anas-ambri/contactless-life-monitoring/host/README.md

#Installation
Need to install libusb and pyusb
libusb doesn't work on mac osx

#Board USB info
Vendor Id = 0x1FC9
Product Id = 0x0081

#Access denied (insufficient permissions)

http://ubuntuforums.org/showthread.php?t=1342955&s=b87c6f5342350bd3af2c09dd516f7416&p=8432338#post8432338
