anas-ambri/contactless-life-monitoring/Algo/figs/dat_diff1.png

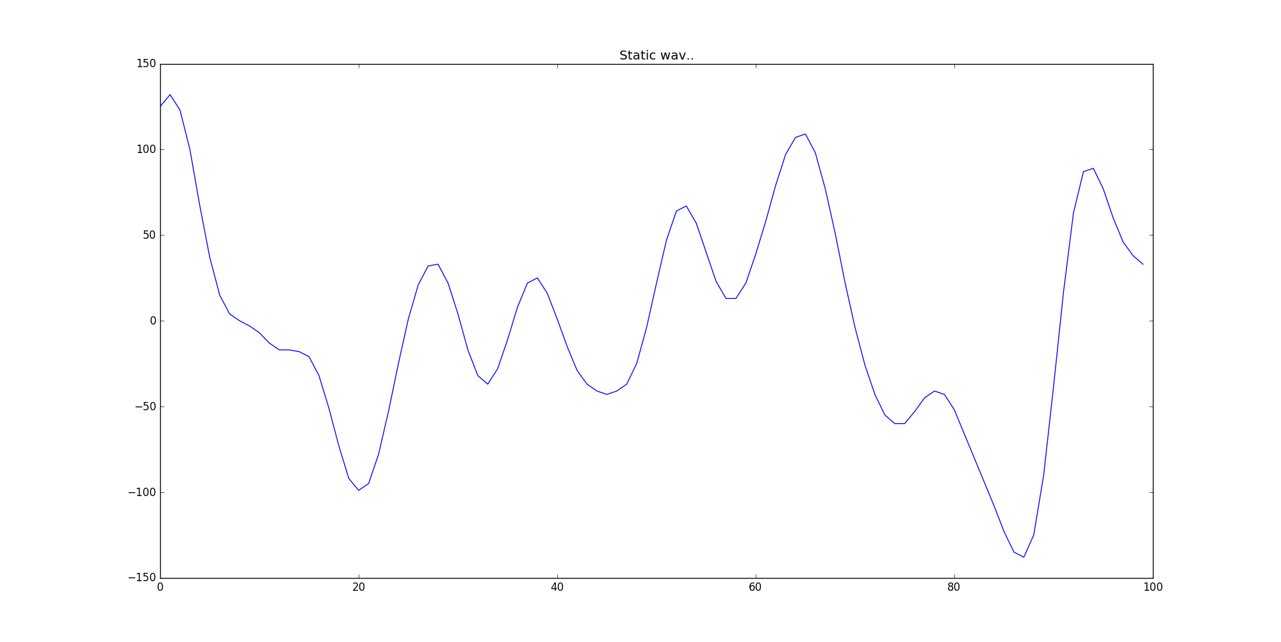
Algo/figs/dat_diff1.png
