anas-ambri/contactless-life-monitoring/antenna/Antenna_housing.stl

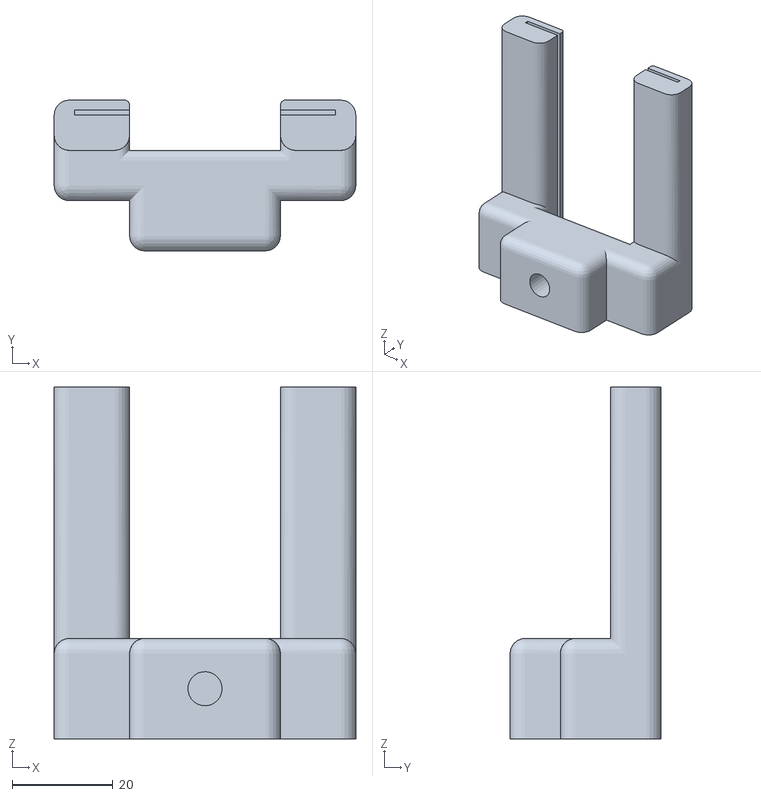
[picture p2: CAD file, 2016-03-30]
antenna/Antenna_housing.stl
60.0 x 30.0 x 70.0
