anas-ambri/contactless-life-monitoring/antenna/Antenna_Base.stl

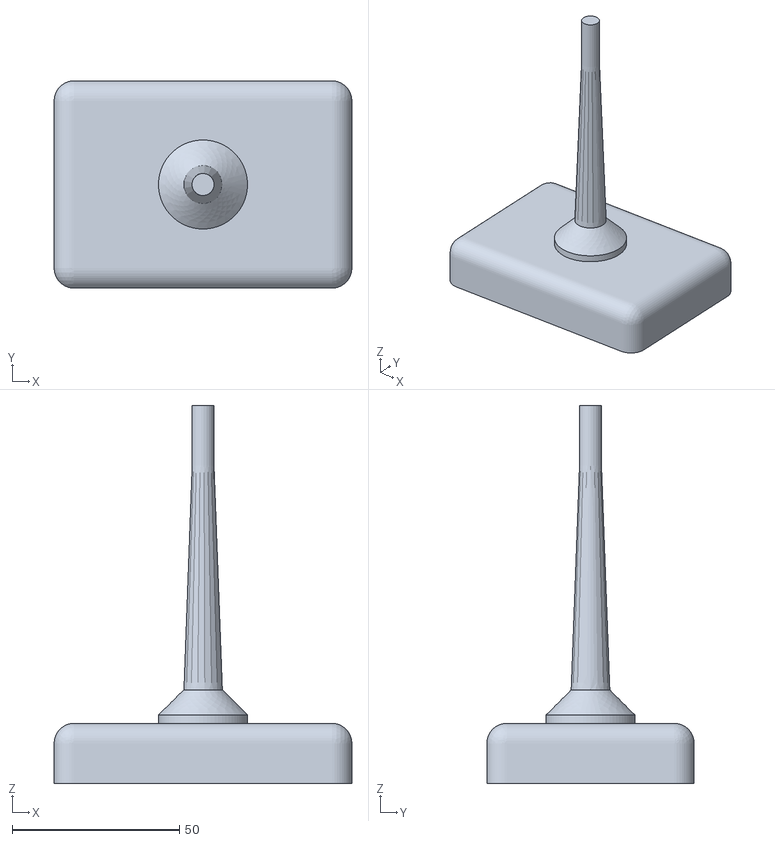
[picture p3: CAD file, 2016-03-30]
antenna/Antenna_Base.stl
89.0 x 62.0 x 113.0
