anas-ambri/contactless-life-monitoring/Algo/figs/figure_1_test1_stereo.png

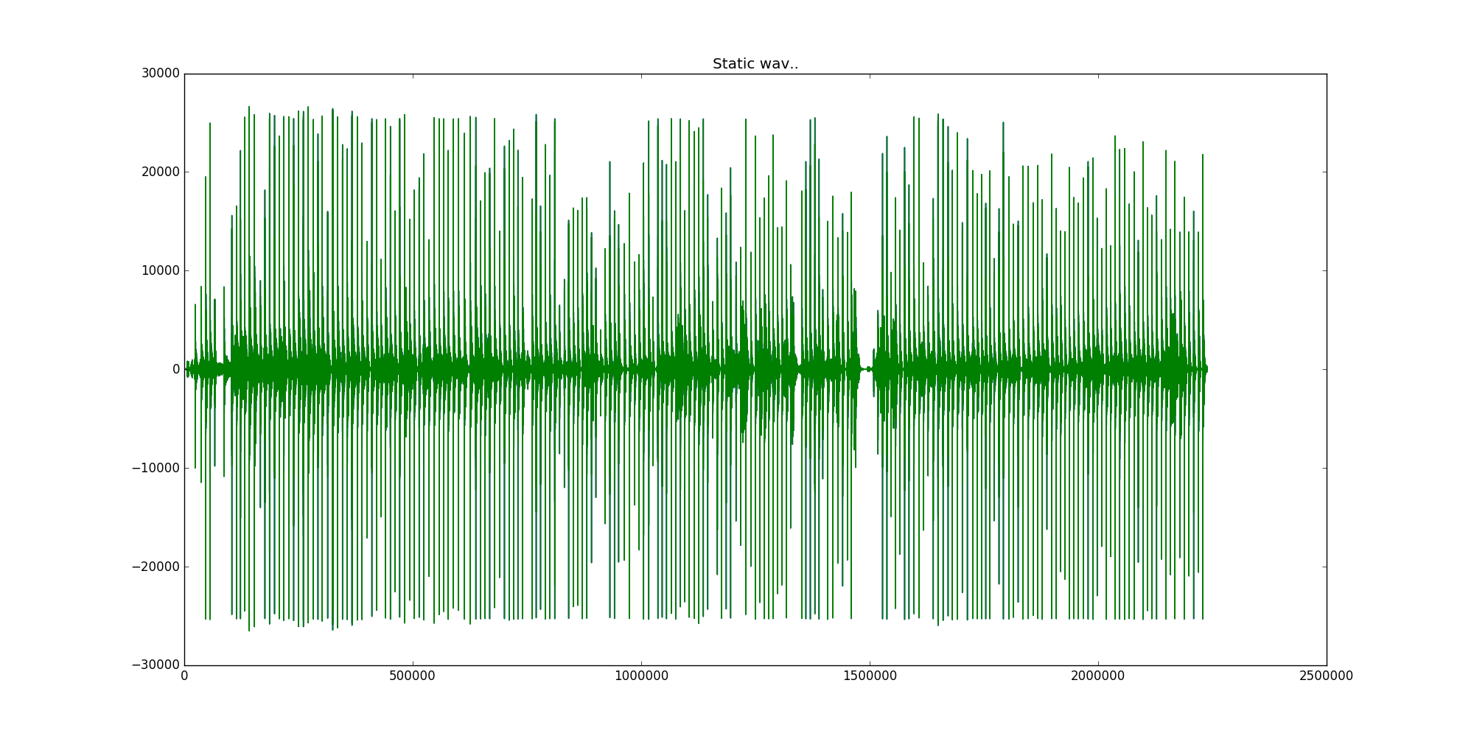
Algo/figs/figure_1_test1_stereo.png
