anas-ambri/contactless-life-monitoring/hardware/Kicad/Capstone.kicad_pcb

## KiCad design hardware/Kicad/Capstone.kicad_pcb (2016-03-30)

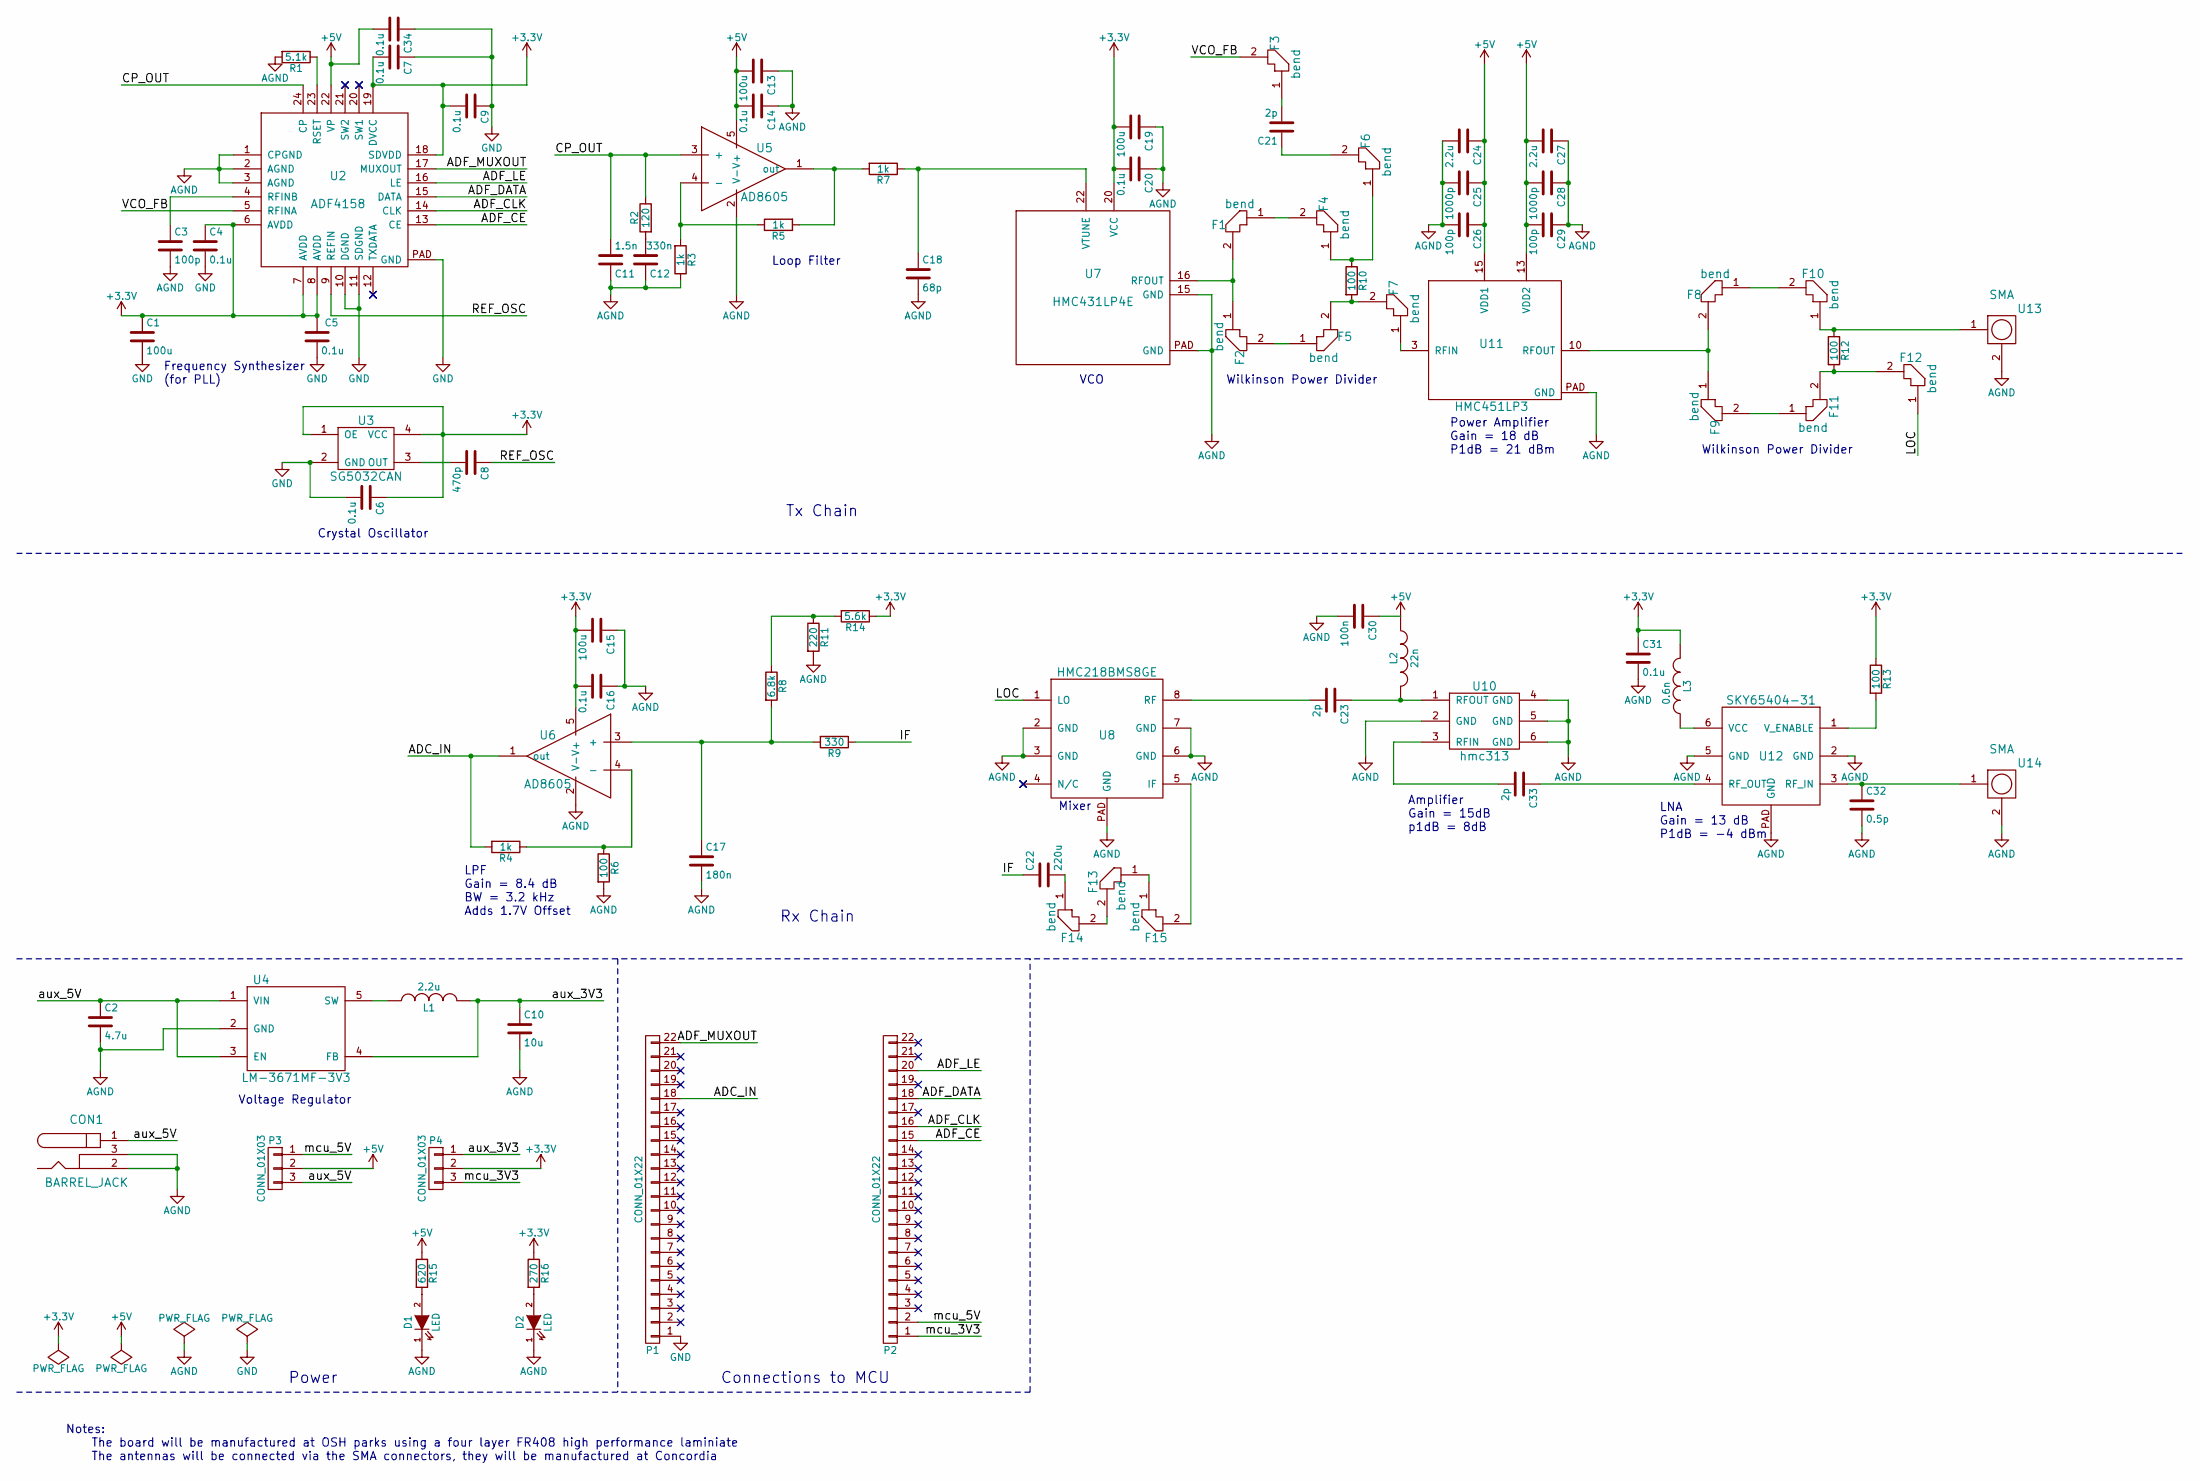
[picture p5: schematic Capstone.sch, FMCW - RF Board]

Parts:
C1, C13, C15, C19: 100u; C_1206
C2: 4.7u; C_0603
C3: 100p; C_0402
C4, C5, C6, C7, C9, C14, C16, C20, C31, C34: 0.1u; C_0805
C8: 470p; C_0805
C10: 10u; C_0805
C11: 1.5n; C_0805
C12: 330n; C_1206
C17: 180n; C_0603
C18: 68p; C_0603
C21, C23, C33: 2p; C_0402
C22: 220u; C_1206
C24, C27: 2.2u; C_0805
C25, C28: 1000p; C_0805
C26, C29: 100p; C_0805
C30: 100n; C_0805
C32: 0.5p; C_0402
CON1: BARREL_JACK
D1, D2: LED; LED_0603
F1, F2, F4, F5, F8, F9, F10, F11: bend; miter_0.17_90
F3, F6, F7, F12, F13, F14, F15: bend; miter_0.34_90
L1: 2.2u; R_0603
L2: 22n; R_0402
L3: 0.6n; R_0402
P1, P2: CONN_01X22; CONN_1x22
P3, P4: CONN_01X03; PWR_exchange
R1: 5.1k; R_0603
R2: 120; R_0603
R3, R4, R5, R7: 1k; R_0805
R6, R10, R12, R13: 100; R_0603
R8: 6.8k; R_0603
R9: 330; R_0603
R11: 220; R_0603
R14: 5.6k; R_0603
R15: 620; R_0603
R16: 270; R_0603
U2: ADF4158; 24-WFQFN
U3: SG5032CAN; 4-SMD
U4: LM-3671MF-3V3; SOT-23-5
U5, U6: AD8605; SOT-23-5
U7: HMC431LP4E; 24-QFN
U8: HMC218BMS8GE; MSOP-8
U10: hmc313; SOT23-6
U11: HMC451LP3; 16-QFN
U12: SKY65404-31; 6-QFN
U13, U14: SMA

Connections:
+3V3: C1.1, C4.1, C5.1, C6.1, C7.2, C9.2, C15.2, C16.2, C19.2, C20.2, C31.1, L3.2, P4.2, R13.1, R14.1, R16.1, U2.6 (AVDD), U2.7 (AVDD), U2.8 (AVDD), U2.18 (SDVDD), U2.19 (DVCC), U3.1 (OE), U3.4 (VCC), U6.5 (V+), U7.20 (VCC)
+5V: C13.2, C14.2, C24.1, C25.1, C26.1, C27.2, C28.2, C29.2, C30.1, C34.2, L2.1, P3.2, R15.1, U2.22 (VP), U5.5 (V+), U11.13 (VDD2), U11.15 (VDD1)
/ADC_IN: P1.18, R4.2, U6.1 (out)
/ADF_CE: P2.15, U2.13 (CE)
/ADF_CLK: P2.16, U2.14 (CLK)
/ADF_DATA: P2.18, U2.15 (DATA)
/ADF_LE: P2.20, U2.16 (LE)
/ADF_MUXOUT: P1.22, U2.17 (MUXOUT)
/CP_OUT: C11.2, R2.1, U2.24 (CP), U5.3 (+)
/IF: C22.1, R9.1
/LOC: F12.1, U8.1 (LO)
/REF_OSC: C8.1, U2.9 (REFIN)
/VCO_FB: F3.2, U2.5 (RFINA)
/aux_3V3: C10.1, L1.2, P4.1, U4.4 (FB)
/aux_5V: C2.1, CON1.1, P3.3, U4.1 (VIN), U4.3 (EN)
/mcu_3V3: P2.1, P4.3
/mcu_5V: P2.2, P3.1
GND: C1.2, C4.2, C5.2, C6.2, C7.1, C9.1, C34.1, P1.1, U2.10 (DGND), U2.11 (SDGND), U2.PAD (GND), U3.2 (GND)
GNDA: C2.2, C3.2, C10.2, C11.1, C12.1, C13.1, C14.1, C15.1, C16.1, C17.2, C18.2, C19.1, C20.1, C24.2, C25.2, C26.2, C27.1, C28.1, C29.1, C30.2, C31.2, C32.2, CON1.2, CON1.3, D1.1 (K), D2.1 (K), R1.2, R3.1, R6.2, R11.2, U2.1 (CPGND), U2.2 (AGND), U2.3 (AGND), U4.2 (GND), U5.2 (V-), U6.2 (V-), U7.15 (GND), U7.PAD (GND), U8.2 (GND), U8.3 (GND), U8.6 (GND), U8.7 (GND), U8.PAD (GND), U10.2 (GND), U10.4 (GND), U10.5 (GND), U10.6 (GND), U11.PAD (GND), U12.2 (GND), U12.5 (GND), U12.PAD (GND), U13.2, U14.2
unnamed: C3.1, U2.4 (RFINB)
unnamed: C8.2, U3.3 (OUT)
unnamed: C12.2, R2.2
unnamed: C17.1, R8.2, R9.2, U6.3 (+)
unnamed: C18.1, R7.1, U7.22 (VTUNE)
unnamed: C21.1, F6.2
unnamed: C21.2, F3.1
unnamed: C22.2, F14.1
unnamed: C23.1, L2.2, U10.1 (RFOUT)
unnamed: C23.2, U8.8 (RF)
unnamed: C32.1, U12.3 (RF_IN), U14.1
unnamed: C33.1, U12.4 (RF_OUT)
unnamed: C33.2, U10.3 (RFIN)
unnamed: D1.2 (A), R15.2
unnamed: D2.2 (A), R16.2
unnamed: F1.1, F4.2
unnamed: F1.2, F2.1, U7.16 (RFOUT)
unnamed: F2.2, F5.1
unnamed: F4.1, F6.1, R10.1
unnamed: F5.2, F7.2, R10.2
unnamed: F7.1, U11.3 (RFIN)
unnamed: F8.2, F9.1, U11.10 (RFOUT)
unnamed: F10.1, R12.1, U13.1
unnamed: F8.1, F10.2
unnamed: F9.2, F11.1
unnamed: F11.2, F12.2, R12.2
unnamed: F13.1, F15.1
unnamed: F13.2, F14.2
unnamed: F15.2, U8.5 (IF)
unnamed: L1.1, U4.5 (SW)
unnamed: L3.1, U12.6 (VCC)
unnamed: R1.1, U2.23 (RSET)
unnamed: R3.2, R5.1, U5.4 (-)
unnamed: R4.1, R6.1, U6.4 (-)
unnamed: R5.2, R7.2, U5.1 (out)
unnamed: R8.1, R11.1, R14.2
unnamed: R13.2, U12.1 (V_ENABLE)

Notes on the sheet:
Mixer
VCO
Frequency Synthesizer (for PLL)
Wilkinson Power Divider
LNA Gain = 13 dB P1dB = -4 dBm
LPF Gain = 8.4 dB BW = 3.2 kHz Adds 1.7V Offset
Power Amplifier Gain = 18 dB P1dB = 21 dBm
Notes: The board will be manufactured at OSH parks using a four layer FR408 high performance laminiate The antennas will be connected via the SMA connectors, they will be manufactured at Concordia
Loop Filter
Crystal Oscillator
Voltage Regulator
Tx Chain
Rx Chain
Power
Connections to MCU
Amplifier Gain = 15dB p1dB = 8dB

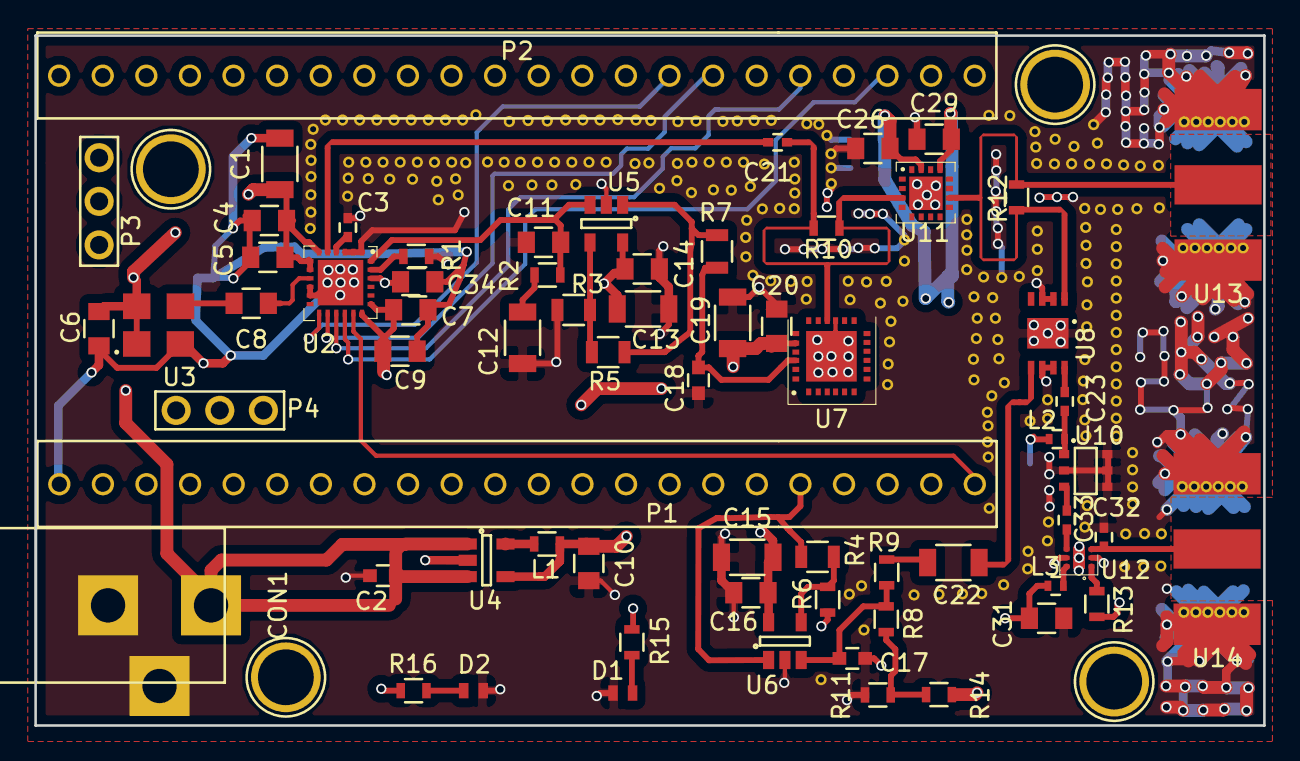
[picture p6: board Capstone.kicad_pcb from above]

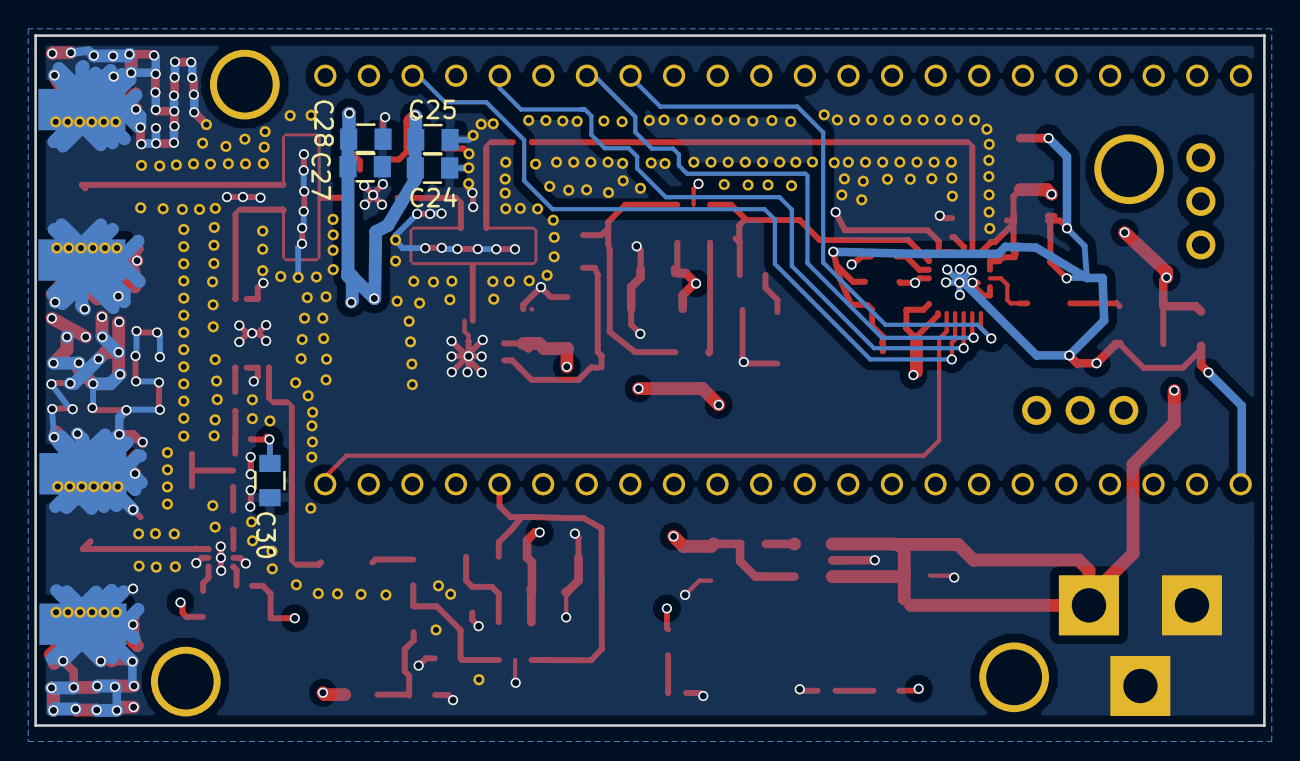
[picture p7: board Capstone.kicad_pcb from below]

Board: 4 copper layers, 71.6 x 40.2 mm, 87 parts (5 on the bottom side), 56 nets.
