anas-ambri/contactless-life-monitoring/UI/src/Test_Trial_2.0.py

import kivy
kivy.require('1.0.6')

from kivy.app import App

from kivy.clock import Clock
from kivy.lang import Builder
from kivy.uix.widget import Widget
from kivy.uix.screenmanager import ScreenManager, Screen
from kivy.uix.progressbar import ProgressBar
from kivy.properties import NumericProperty, BooleanProperty ,StringProperty,ListProperty

import usb.core
import time

dev = usb.core.find()
dev.read(0x81, 576)

import sys
import time

#Globals
ticks=0 # total run time
s_state=0 # screen state-> 0:welcome screen, 1: main screen
heart=0.0# heart rate
breath=0.0 # breathing rate
# Debug values
# optimal values
h_buffer = [54.4,55.0, 60.5,67.8,65.3,66.2,63.1,63.8,70.0]
b_buffer = [14.4,15.0, 12.5,17.8,15.3,16.2,13.1,13.8,20.0]

# suboptimal values
#h_buffer = [34.4,35.0, 40.5,37.8,25.3,26.2,23.1,33.8,35.0]
#b_buffer = [8.4,9.0, 7.5,7.8,5.3,7.2,9.1,7.8,8.0]

# over_optimal values
#h_buffer = [164.4,185.0, 190.5,187.8,195.3,186.2,183.1,183.8,185.0]
#b_buffer = [68.4,69.0, 67.5,67.8,75.3,67.2,59.1,67.8,68.0]


i = 0
first_v= True

# Create both screens. Please note the root.manager.current: this is how
# you can control the ScreenManager from kv. Each screen has by default a
# property manager that gives you the instance of the ScreenManager used.
Builder.load_string("""
<WelcomeScreen>:
    Widget:
        Button:
            text: 'Start'
       #    size: 100,50
            size: 200,50
            font_size:'20sp'
       #    pos: (root.width/2)-50,50
            pos: (root.width/2)-100,75
            color: 153, 153, 102
            bold: True
            on_press:
                root.manager.transition.direction = 'left'
                root.manager.current = 'settings'
                root.setmainstate(self,*args)
        #Button:
        #   text: 'Quit'
        #    size: 100,50
        #    font_size:'20sp'
        #    pos: root.width-130,50
        #    color: 153, 153, 102
        #    bold: True
        #    on_press:root.close(event)
            
        Label:
            text:'cVitals'
            font_size:'125sp'
            color: 0,255,255,1
            bold:True
            pos: (root.width/2)-50,(root.height/2)+100
            
        # Image made by Freepik at:http://www.flaticon.com/free-icon/fingerprint-heart-shape_32692
        #Image:
        #    source: '..\Icons\shape.png'
        #    size: 150,150
        #    pos: (root.width/2) -75, 200
                
        # Image made by Freepik: http://www.flaticon.com/free-icon/heart-checkup_33149
        Image:
            source: '..\Icons\medical.png'
            size: 150,150
            pos: (root.width/2) -75, 200


<MainScreen>:
    Widget:
        color: 229, 255, 255
    
        GridLayout:
            id: Heart_layout
            cols:1
            #default design
            rows:3
            #pending  design
            #
            #pos:(root.width/2)-200,(root.height/2)+150)
            pos:150,(root.height/2)+150
            font_size:'40sp'
            col_default_width: 100
            row_default_width: 50
            row_default_height: 100
            
            Label:
                text:'Heart Rate :'
                color: 0,255,255,1
                bold: True

            Image:
                #source: '..\Icons\heart2.gif'
                
                #http://www.flaticon.com/free-icon/heart-black-shape_46029
                source: '..\Icons\heart-black-shape.png'
                size: 75,75
                
            Label:
                id: heart_label
                text: root.heart_rate
                color: root.h_monitor
                font_size:'125sp'
               
                

        GridLayout:
            id: Breath_layout
            cols:1
            rows:3
            #pos:(root.width/2)+200,((root.height/2)+150)
            pos: (root.width-250),((root.height/2)+150)
            font_size:'40sp'
            col_default_width: 100
            row_default_width: 50
            row_default_height: 100
            
            Label:
                text: 'Breathing Rate :'
                font_size:'15sp'
                color: 0,255,255,1
                bold: True

            Image:
                #source: '..\Icons\lungs2.gif'

                #http://www.flaticon.com/free-icon/breath-control_95799
                #source: '..\Icons\breath-control.png'

                #http://www.flaticon.com/free-icon/lungs-silhouette_45987
                source: '..\Icons\lungs-silhouette.png'
                size: 75,75
                
            Label:
                text: root.breath_rate
                id: chest_label
                color: root.b_monitor
                font_size:'125sp'
        
        Label:
        #   cal_prog is an id
        #   text: 'Calibration :{}%'.format(int(cal_prog.value))
            text: root.cal_display
            size_hint_x:None
            font_size:'25sp'
            bold: True
            pos:(root.width/2)-50,150

        
        ProgressBar:
            pos:(root.width/2)-125,150
            id: cal_prog
            size_hint_x: 1.0
            size_hint_y: None
            size: 250,10
            value: root.cal_progress
            
        Button:
            id: all_start
            text: 'New Patient'
            size: 150,50
            font_size:'20sp'
            pos: (root.width/2)-275,50
            color: 153, 153, 102
            bold: True
            on_press:
                #root.start_cal(self, *args)
                root.resetrates(self, *args)
                #root.cal_pop.open()   
          
        Button:
            id:bye_felicia
            text: 'Return'
            size: 150,50
            font_size:'20sp'
            color: 153, 153, 102
            pos: (root.width-275),50
            bold: True
            on_press:
                root.return_clear(self,*args)
                root.manager.transition.direction = 'right'
                root.manager.current = 'menu'
                root.setwelcstate(self,*args)

            

""")



# Declare both screens
class WelcomeScreen(Screen):
    
    # change screen states so we know which screen we are on
    def setmainstate(self, *args):
        global s_state
        s_state = 1
        
    #exit function
    # not complete yet
    def close(event):
        
        sys.exit()
    

class MainScreen(Screen):
    heart_rate = StringProperty()
    breath_rate = StringProperty()
    cal_progress = NumericProperty(0)
    cal_display = StringProperty()
    # cal_start - marks that cal has started, false if not started
    cal_start = BooleanProperty(False)
    cal_done = BooleanProperty(False)

    #rate color settingss
    h_monitor = ListProperty([1,1,1,1])
    b_monitor = ListProperty([1,1,1,1])

    #allow update of rates in all respects-screen and back-end
    # used to be used in stop function
    #
    can_refresh = BooleanProperty(True)
    accept_data = BooleanProperty(False)

    # if first batch of 12.5ms  
    first_batch = BooleanProperty(False) 

    def __init__(self, **kwargs):
        super(MainScreen, self).__init__(**kwargs)
        self.heart_rate = str('--')
        self.breath_rate = str('--')
        self.cal_progress = 0
        self.cal_start = False
        self.cal_done = False
        Clock.schedule_interval(self._cal_clock, 0.1)
        Clock.schedule_interval(self.ratecalculation, 0.5)
        Clock.schedule_interval(self.refresh_clock, 1)
        Clock.schedule_interval(self.algo, 0.03) # inte
    
    # On start button press, calibrate 10 sec
    def start_cal(self, *args):
        self.cal_start = True
        self.accept_data = True
        
    def _cal_clock(self, *args):
        #debug
        #print('cal_clock called')
        #print (self.cal_start)
        if (not(self.cal_start)):
            # if calibration has not been started dont display calibration progress
            self.cal_display = str('')
            #self.cal_display = str('Calibration :{}%'.format(int(self.cal_progress)))
        
        if (self.cal_progress <=100 and self.cal_start and not(self.cal_done)):
            #self.cal_display = str('Calibration :{}%'.format(int(self.cal_progress)))
            self.cal_progress = (self.cal_progress+1)%101
            self.cal_display = str('Calibration :{}%'.format(int(self.cal_progress)))

            if self.cal_progress==100:
                #self.cal_display = str('Calibration :Done')
                self.cal_done = True
                self.cal_display = str('')

    # screen refresh every 1 sec
    def refresh_clock(self, *args):
        global heart,breath
        if self.cal_done and self.can_refresh:
            tempheart_rate = str (int(heart))
            tempbreath_rate = str (int(breath))
            self.heart_rate = tempheart_rate[:5]
            self.breath_rate = tempbreath_rate[:5]
            if (heart< 39.0 or heart> 170.0):
                self.h_monitor = [255,0,0,1]
            else:
                self.h_monitor = [0,255,255,1]
                
            if (breath < 10.0 or breath >59.0):
                self.b_monitor =[255,0,0,1]
            else:
                self.b_monitor = [0,255,255,1]
        

    # On reset button press,effectively a recalibration
    def resetrates(self, *args):
        #print ('Log: Recalibration asserted')
        print ('Log: New Patient asserted')
        global heart
        global breath,first_v
        #self.return_clear(self,*args)
        #print('Log: Return to Welc screen.Clear all data and screen')
        #global heart
        #global breath,first_v
        heart = 0.0
        breath = 0.0
        self.h_monitor = [1,1,1,1]#[255,0,0,1]
        self.b_monitor =[1,1,1,1]#[255,0,0,1]
        first_v= True
        self.heart_rate = str('--')
        self.breath_rate = str('--')
        self.cal_progress = 0
        self.cal_start = False
        self.cal_done = False
        self.accept_data = False
        
        self.start_cal(self, *args)


    # change screen states so we know which screen we are on
    def setwelcstate(self, *args):
        global s_state
        s_state = 0

    # On stop press suspend all logging and refreshing
    # "Stop" button discontinued
    #def stop_refresh(self, *args):
        #self.can_refresh = False
        #self.accept_data = False
        #print ('Log: Refreshes disabled')
        
    # calculate rates
    def ratecalculation(self, *args):
        # using ui mock data
        global i,breath,heart,h_buffer,b_buffer,first_v

        if(self.can_refresh and self.accept_data):
            if (first_v):
                breath = (breath + b_buffer[i])
                heart = (heart + h_buffer[i])
                first_v =False
                i= (i +1)%10
            else:
                breath = (breath + b_buffer[i])/2
                heart = (heart + h_buffer[i])/2
                (i +1)%10
        print('Heart:' ,heart)
        print('Breath:' , breath)

        # using real data

    # On return: clear screen and reset all data
    
    def return_clear(self,*args):
        print('Log: Return to Welc screen.Clear all data and screen')
        global heart
        global breath,first_v
        heart = 0.0
        breath = 0.0
        self.h_monitor = [1,1,1,1]#[255,0,0,1]
        self.b_monitor =[1,1,1,1]#[255,0,0,1]
        first_v= True
        self.heart_rate = str('--')
        self.breath_rate = str('--')
        self.cal_progress = 0
        self.cal_start = False
        self.cal_done = False
        self.accept_data = False
        
    #get me unit batch 
    def getnext(self, *args):
        global dev
        ret = dev.read(0x81, 576)
        return ret

    # algorithm
    def algo(self,*args):
        # if accept data true run algo else skip
        if(self.accept_data):
            # start work
            # if first batch call getnext 6 times
            if (self.first_batch):
                for x in range(0, 6):
                    #mark time
                    start_time1 = time.time() 
                    values = self.getnext(self, *args)
                    end_time1 = time.time()
                    print "Exec:", end_time1-start_time1
                    #sleep(0.001)
                self.first_batch = False
                
            else:
                # top off to 6 batches
                for x in range(0, 6):
                    #mark time
                    start_time = time.time() 
                    self.getnext(self, *args)
                    end_time = time.time()
                    print "Exec top off:", end_time-start_time
            
        
    

# Create the screen manager
sm = ScreenManager()
sm.add_widget(WelcomeScreen(name='menu'))
sm.add_widget(MainScreen(name='settings'))

class TestApp(App):
      
    title = 'cVitals'
    icon =  '..\Icons\medical_32.png'
    def build(self):        
        Clock.schedule_interval(self.op_clock, 1)
        return sm

    

    
        


#app runtime + rate update interval 
    def op_clock(self, dt):
        global ticks
        global s_state
        ticks=(ticks+1)%10
        print(ticks)
        global s_state
        if s_state == 0:
            print ('Log: Current Screen->welc')
        else:
            print ('Log: Current Screen->main')


if __name__ == '__main__':
    TestApp().run()
