anas-ambri/contactless-life-monitoring/(commit log)

2016-02-07 Adding windows drivers
2016-02-12 Added basic static path, still need to optimize sample batch sizes
2016-02-14 Rename hid_main into main, added logic for collecting data from ADC
2016-02-15 Fix LED flash
2016-02-22 Add file with weird voltages off pins
2016-02-25 Weird voltages
2016-03-10 Added python program that creates 2 way communication with board. Missing: controlling data being sent
    [hid_generic.c, hid_generic.h, host.py, main.c, pll_programmer.ino.ino, pll_programmer_CW.ino, simple_send.py]
2016-03-17 Uncomment USB & ADC
2016-03-20 Add antenna design files
    [Antenna_Base.stl, Antenna_housing.stl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]
2016-03-21 Add hardware folder
    [Capstone-B_Cu.gbl, Capstone-B_Mask.gbs, Capstone-B_SilkS.gbo, Capstone-Edge_Cuts.gko, Capstone-F_Cu.gtl, Capstone-F_Mask.gts, Capstone-F_SilkS.gto, Capstone.drl]
